Eben-Siyabalapitiya/Motion-light-controller/(commit log)

2026-08-06 Servo Test code with esp32
2026-08-06 Enhance motion light controller functionality
    Refactor motion detection logic and servo control.
2026-08-06 Refactor servo angles and update initialization
2026-08-06 Fix formatting and add newline at end of file
    [Motion-light-controller.ino]
2026-08-06 Refactor servo control logic for motion detection
2026-08-06 Implement PIR sensor warmup and logging
    Added warmup period for PIR sensor and improved logging.
2026-08-06 Update motion detection and servo control logic
    Refactor motion detection logic and simplify servo control.
2026-08-06 Enhance motion detection to hold servo position
    Added logic to hold the servo in the up position for a specified duration after detecting motion.
2026-08-08 Adjust servo angles for motion light controller
2026-08-08 Change servo angle from 60 to 40 degrees
2026-08-08 Change servo angle from 40 to 50 degrees
2026-08-08 Change servo angle from 0 to 30 degrees
2026-08-08 Change servo angle from 60 to 65 degrees
2026-08-08 Add LED control and blink function
    Added LED blinking functionality when the servo moves down.
2026-08-08 Refactor motion light controller to use blue and red LEDs
    Replace LED with blue and red pins for motion indication. Implement blinking for the red pin when the servo is down.
    [Motion-light-controller.ino]
2026-08-08 Replace blue LED with green LED in motion controller
    [Motion-light-controller.ino]
2026-08-08 Change green LED to blue LED in motion controller
2026-08-08 Change HOLD_MS from 5000UL to 300000UL
    Increased hold time for the servo from 5000ms to 300000ms.
2026-08-15 Modify chip grid and button styles in index.html for demo 3 sec delay
    Updated chip layout and styling in index.html. for demo
2026-08-15 fix servo bug
2026-08-15 Update README with capacitor recommendation for servo
    Added recommendation for capacitor to stabilize servo power.
